Wirehive/PiDoor/pidoor/pidoor.pdf

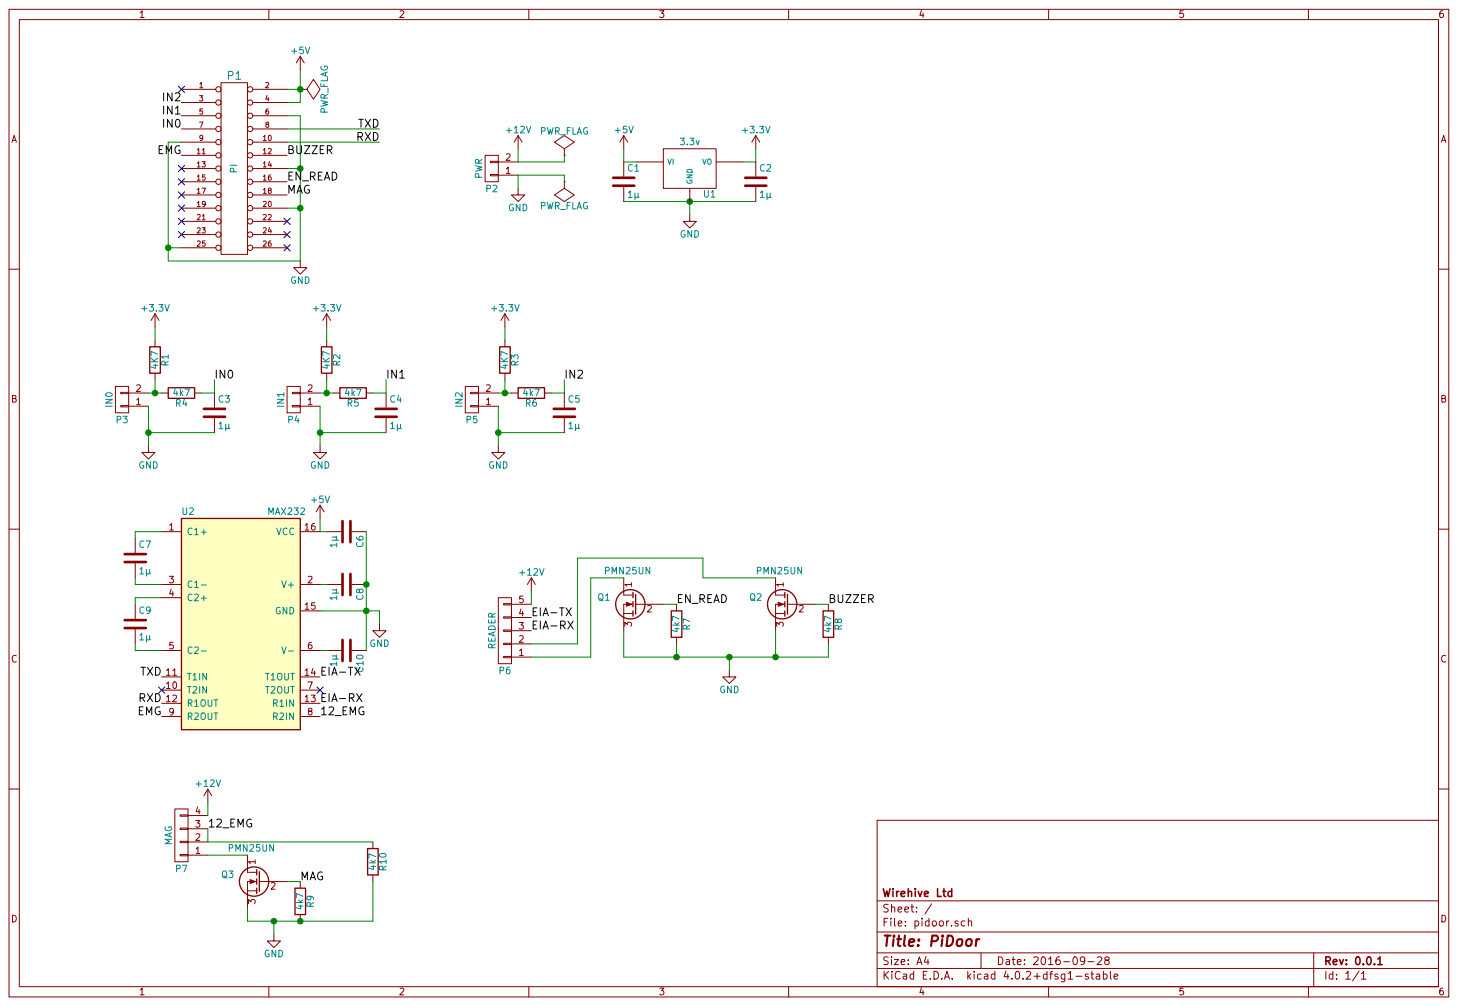
[picture p1: page 1]

File: pidoor.sch Sheet: / Wirehive Ltd
