Wirehive/PiDoor/pidoor/out/pidoor.pdf

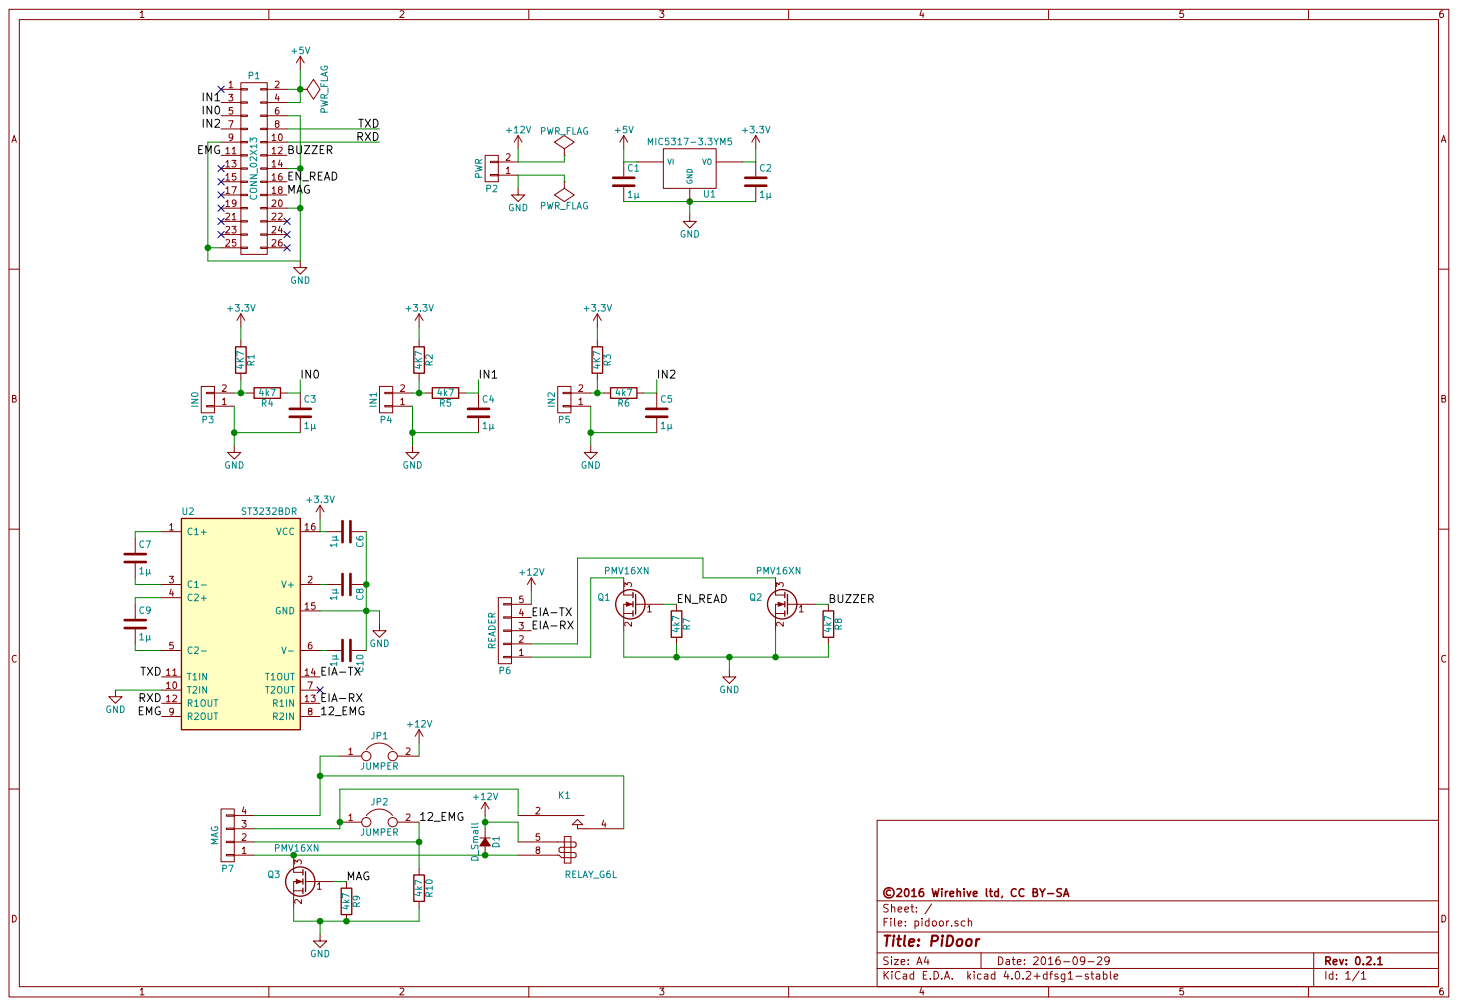
[picture p2: page 1]

File: pidoor.sch Sheet: / ©2016 Wirehive ltd, CC BY-SA
