Wirehive/PiDoor/rfidreaderback/out/rfidreaderback.pdf

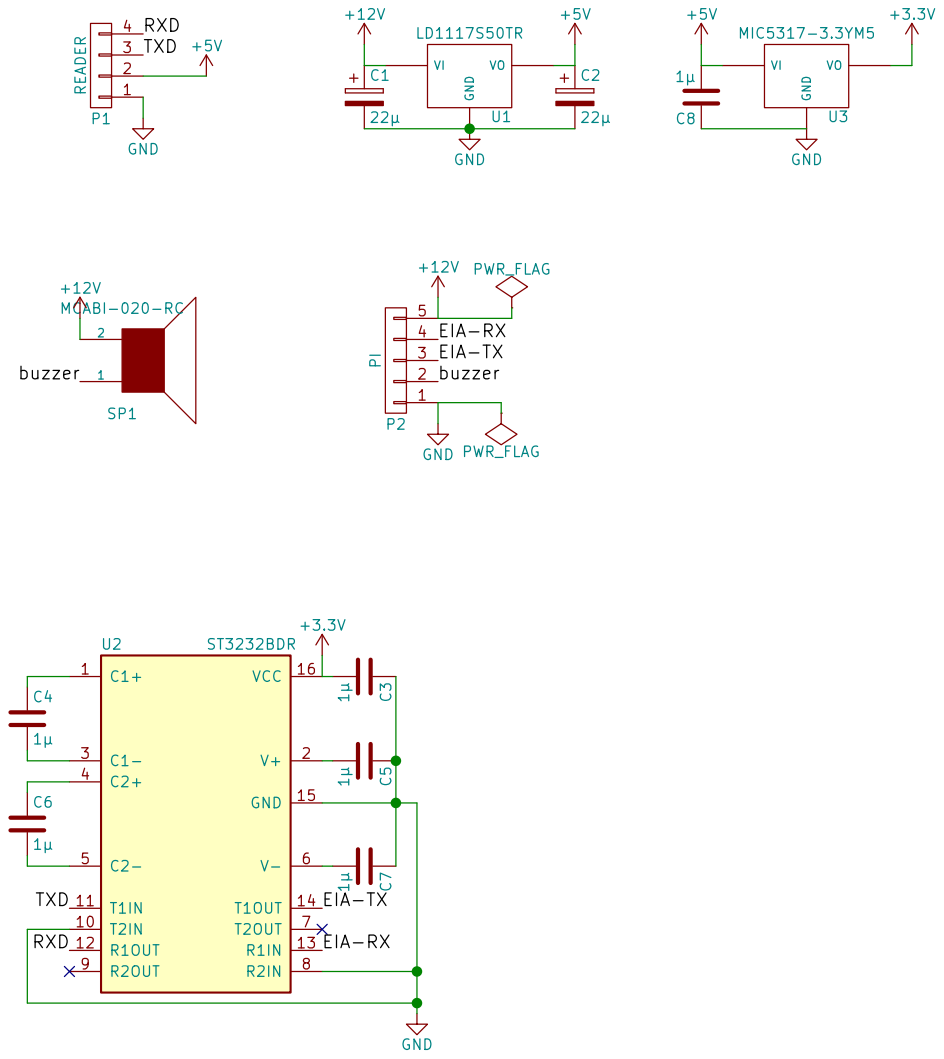
[picture p3: page 1]

File: rfidreaderback.sch Sheet: / ©2016 Wirehive ltd, CC BY-SA

Id: 1/1 Title: RFID Reader Back
