Wirehive/PiDoor/pidoor/out/pidoor-back.pdf

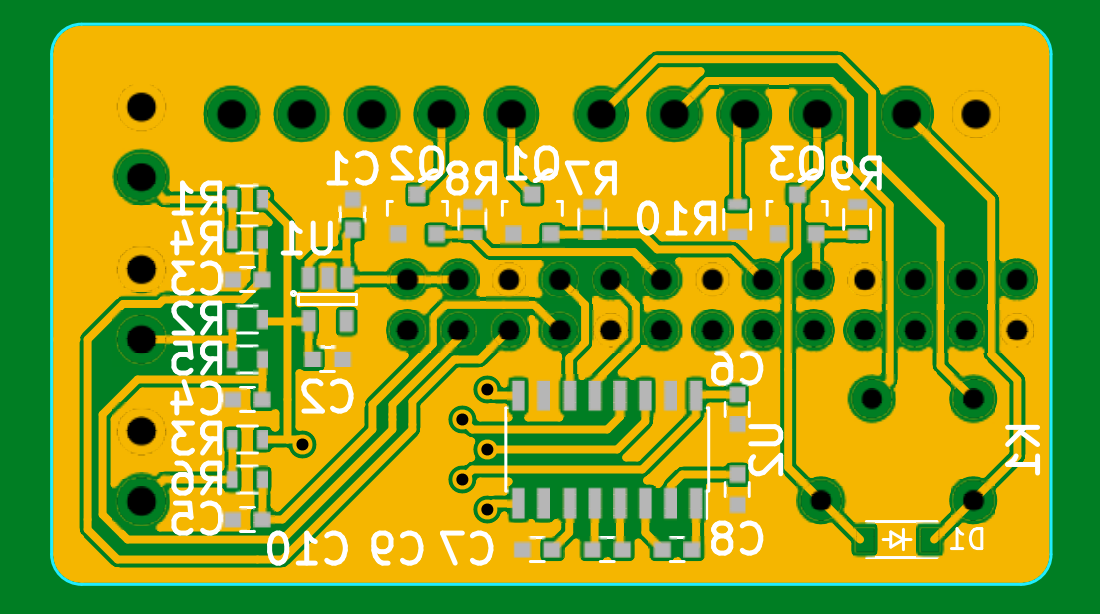
[picture p4: page 1]
