Wirehive/PiDoor/pidoor/out/pidoor-front.pdf

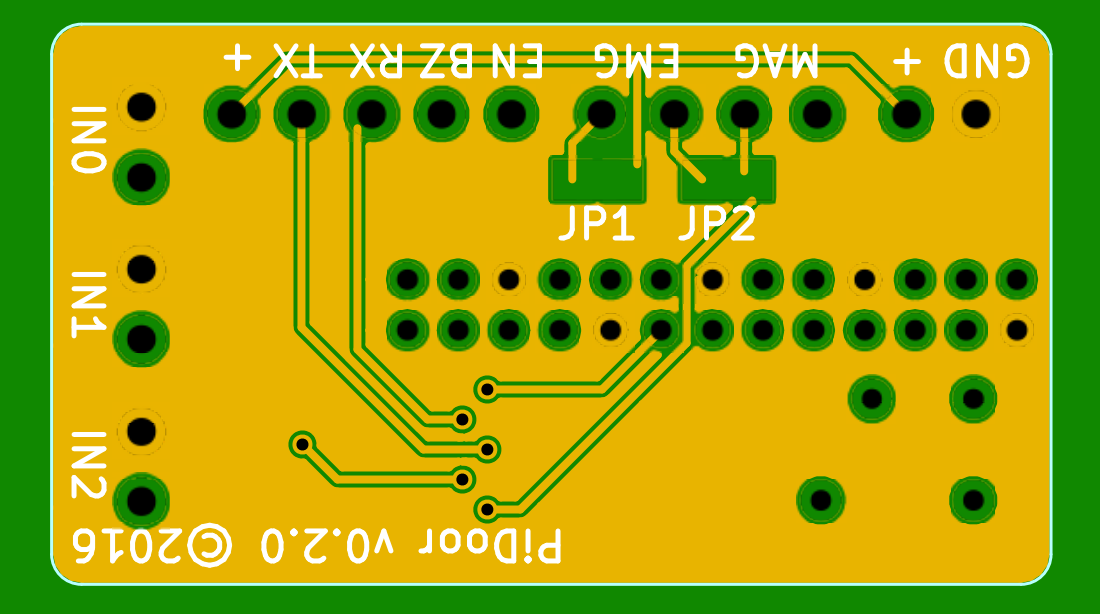
[picture p5: page 1]
