Wirehive/PiDoor/rfidreaderback/out/rfidreaderback-front.pdf

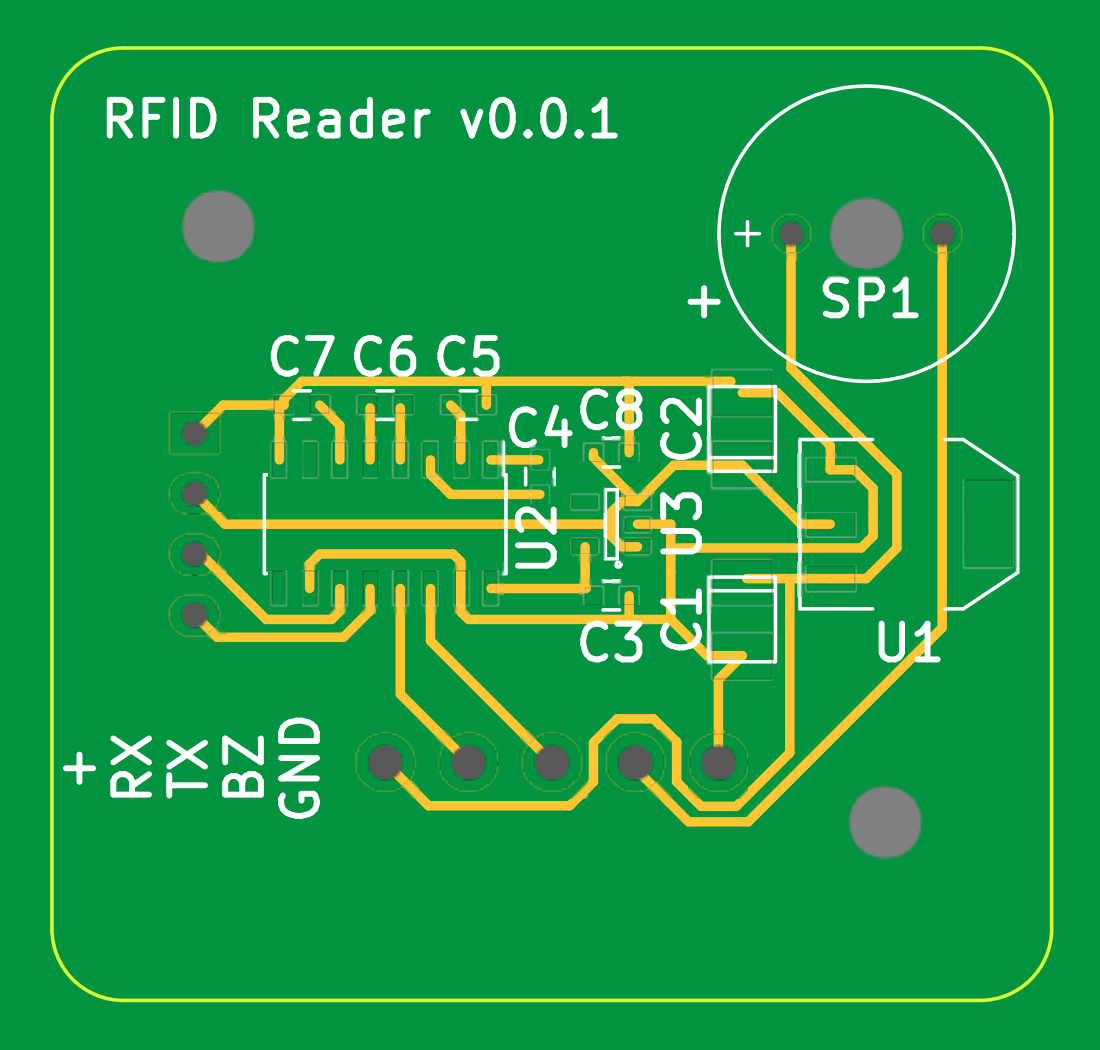
[picture p6: page 1]
