Wirehive/PiDoor/rfidreaderback/rfidreaderback.kicad_pcb

## KiCad design rfidreaderback/rfidreaderback.kicad_pcb (2016-10-25)

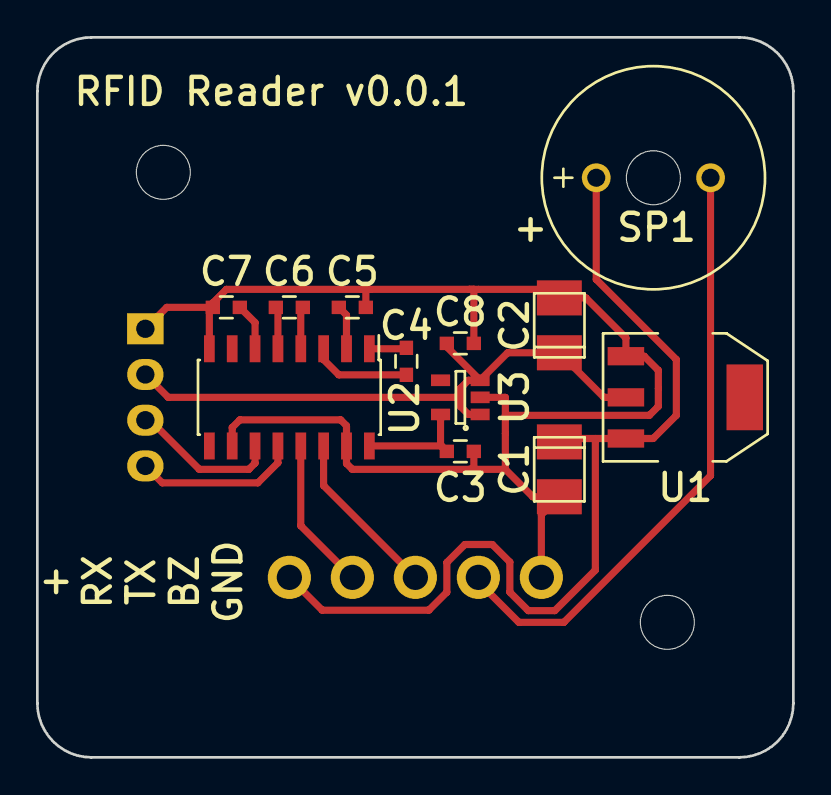
[picture p7: board rfidreaderback.kicad_pcb from above]

Board: 2 copper layers, 42.0 x 40.0 mm, 14 parts (1 on the bottom side), 15 nets.

Parts:
C1, C2: 22µ; TantalC_SizeT_EIA-3528
C3, C4, C5, C6, C7, C8: 1µ; C_0603
P1: READER; Socket_Strip_Straight_1x04
P2: PI; 3_5mm_terminal_1x05
SP1: MCABI-020-RC; MagneticBuzzer_ProSignal_ABT-410-RC
U1: LD1117S50TR; SOT-223
U2: ST3232BDR; SOIC-16_3.9x9.9mm_Pitch1.27mm
U3: MIC5317-3.3YM5; SOT-23-5

Connections:
+3V3: C3.2, U2.16, U3.VO
+5V: C2.1, C8.2, P1.2, U1.VO, U3.VI
+12V: C1.1, P2.5, SP1.2, U1.VI
/EIA-RX: P2.4, U2.13
/EIA-TX: P2.3, U2.14
/RXD: P1.4, U2.12
/TXD: P1.3, U2.11
/buzzer: P2.2, SP1.1
GND: C1.2, C2.2, C3.1, C5.1, C7.1, C8.1, P1.1, P2.1, U1.GND, U2.8, U2.10, U2.15, U3.GND
unnamed: C4.1, U2.1
unnamed: C4.2, U2.3
unnamed: C5.2, U2.2
unnamed: C6.1, U2.4
unnamed: C6.2, U2.5
unnamed: C7.2, U2.6
