Wirehive/PiDoor/pidoor/pidoor.kicad_pcb

## KiCad design pidoor/pidoor.kicad_pcb (2016-10-25)

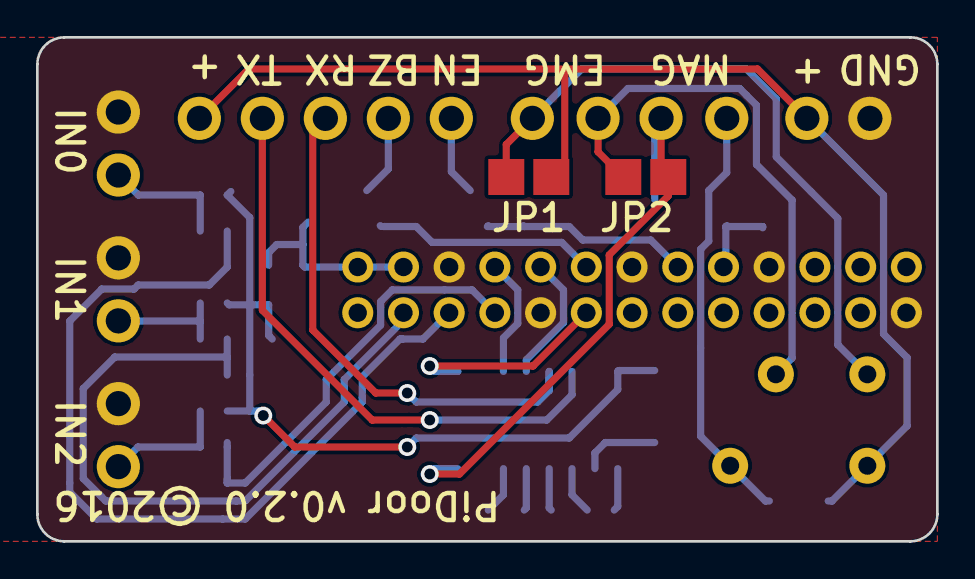
[picture p8: board pidoor.kicad_pcb from above]

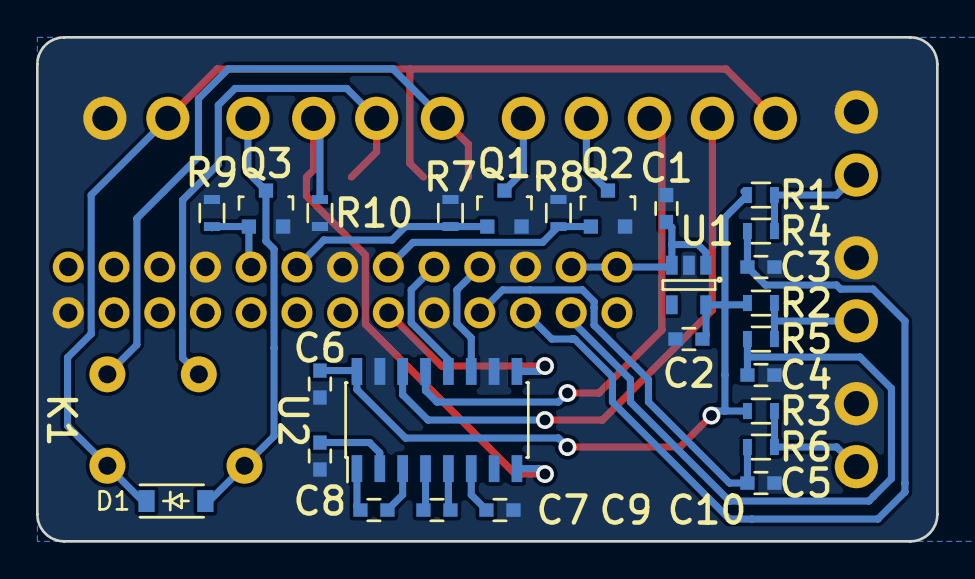
[picture p9: board pidoor.kicad_pcb from below]

Board: 2 copper layers, 50.0 x 28.0 mm, 36 parts (34 on the bottom side), 30 nets.

Parts:
C1, C2, C3, C4, C5, C6, C7, C8, C9, C10: 1µ; C_0603
D1: D_Small; SOD-123
JP1, JP2: JUMPER; SMD_Jumper
K1: RELAY_G6L; Relay_G6L
P1: CONN_02X13; Socket_Strip_Straight_2x13
P2: PWR; 3_5mm_terminal_1x02
P3: IN0; 3_5mm_terminal_1x02
P4: IN1; 3_5mm_terminal_1x02
P5: IN2; 3_5mm_terminal_1x02
P6: READER; 3_5mm_terminal_1x05
P7: MAG; 3_5mm_terminal_1x04
Q1, Q2, Q3: PMV16XN; SOT-23
R1, R2, R3: 4K7; R_0603
R4, R5, R6, R7, R8, R9, R10: 4k7; R_0603
U1: MIC5317-3.3YM5; MIC5317
U2: ST3232BDR; SOIC-16_3.9x9.9mm_Pitch1.27mm

Connections:
+3V3: C2.1, C6.2, R1.1, R2.1, R3.1, U1.VO, U2.16
+5V: C1.1, P1.2, P1.4, U1.VI
+12V: D1.1, JP1.2, K1.5, P2.2, P6.5
/12_EMG: JP2.2, P7.2, R10.1, U2.8
/BUZZER: P1.12, Q2.1, R8.1
/EIA-RX: P6.3, U2.13
/EIA-TX: P6.4, U2.14
/EMG: P1.11, U2.9
/EN_READ: P1.16, Q1.1, R7.1
/IN0: C3.1, P1.5, R4.1
/IN1: C4.1, P1.3, R5.1
/IN2: C5.1, P1.7, R6.1
/MAG: P1.18, Q3.1, R9.1
/RXD: P1.10, U2.12
/TXD: P1.8, U2.11
GND: C1.2, C2.2, C3.2, C4.2, C5.2, C6.1, C8.1, C10.1, P1.6, P1.9, P1.14, P1.20, P1.25, P2.1, P3.1, P4.1, P5.1, Q1.2, Q2.2, Q3.2, R7.2, R8.2, R9.2, R10.2, U1.GND, U2.10, U2.15
unnamed: C7.1, U2.1
unnamed: C7.2, U2.3
unnamed: C8.2, U2.2
unnamed: C9.1, U2.4
unnamed: C9.2, U2.5
unnamed: C10.2, U2.6
unnamed: D1.2, K1.8, P7.1, Q3.3
unnamed: JP1.1, K1.4, P7.4
unnamed: JP2.1, K1.2, P7.3
unnamed: P3.2, R1.2, R4.2
unnamed: P4.2, R2.2, R5.2
unnamed: P5.2, R3.2, R6.2
unnamed: P6.1, Q1.3
unnamed: P6.2, Q2.3
