Wirehive/PiDoor/(commit log)

2016-09-28 door electronics
    [pidoor.kicad_pcb, pidoor.sch, rfidreaderback.kicad_pcb, rfidreaderback.sch]
2016-09-30 RFID back
    [pidoor-B.Cu.gbl, pidoor-B.Mask.gbs, pidoor-B.SilkS.gbo, pidoor-Edge.Cuts.gm1, pidoor-F.Cu.gtl, pidoor-F.Mask.gts, pidoor-F.SilkS.gto, pidoor.drl]
2016-10-03 Probably best if the level converters are connected to the correct level
    [pidoor.kicad_pcb, pidoor.sch, rfidreaderback.kicad_pcb, rfidreaderback.sch]
2016-10-03 relay for AC strikers
    [pidoor.kicad_pcb, pidoor.sch]
2016-10-03 switch unnecisarry milling to drill
    [rfidreaderback-B.Cu.gbl, rfidreaderback-B.Mask.gbs, rfidreaderback-B.Paste.gbp, rfidreaderback-B.SilkS.gbo, rfidreaderback-Edge.Cuts.gm1, rfidreaderback-F.Cu.gtl, rfidreaderback-F.Mask.gts, rfidreaderback-F.Paste.gtp]
2016-10-04 ascii really
    [pidoor.csv, rfidreaderback.csv]
2016-10-06 gnd unused inputs
    [pidoor-B.Cu.gbl, pidoor-B.Mask.gbs, pidoor-B.Paste.gbp, pidoor-B.SilkS.gbo, pidoor-Edge.Cuts.gm1, pidoor-F.Cu.gtl, pidoor-F.Mask.gts, pidoor-F.Paste.gtp]
2016-10-25 pre-production tweeks
    [pidoor-B.Cu.gbl, pidoor-B.Mask.gbs, pidoor-B.Paste.gbp, pidoor-B.SilkS.gbo, pidoor-Edge.Cuts.gm1, pidoor-F.Cu.gtl, pidoor-F.Mask.gts, pidoor-F.Paste.gtp]
2016-10-31 Pi's pin 1 and 2 have strong pullups so we don't want more, or to create a divider; Mag collaps blows MosFETs, prodect with at least a MOV
    [pidoor.sch]
