Wirehive/PiDoor/(notices)

Notices in the files:
pidoor/pidoor.kicad_pcb:
PiDoor v0.2.0 ©2016
